penkovlab/6CH_DMX_DECODER/README.md

# 6CH_DMX_DECODER
DMX декодер предназначен для установки внутрь светодиодного светильника. Преобразует цифровой сигнал DMX512 в ШИМ (сигнал с широтно-импульсной модуляцией). К выходу устройства подключаются светодиодные драйверы с ШИМ управлением яркостью. Совместимость с протоколом DMX-512 позволяет управлять световым прибором с любого DMX контроллера.
6CH_DMX_48V(1)
6CH_DMX_48V(2)
# Характеристики
    • Напряжение питания: 9-48 В
    • Потребляемый ток при 9В: 80 мА
    • Потребляемый ток при 48В: 16 мА
    • Входной сигнал: DMX512
    • Число выходных каналов: 6
    • Тип выхода: открытый коллектор
    • Максимальный ток выхода: 250 мА
    • Максимальное напряжение на выходе: 48 В
    • Частота выходного ШИМ сигнала: 120/490/3900 Гц
    • Разрешение выходного ШИМ сигнала: 8 бит
    • Габаритные размеры: 65 * 30 * 18 мм (Д*Ш*В)
# Особенности
    • Гальваническая изоляция линии DMX.
    • Стартовый адрес устанавливается при помощи редактора адресов по линии DMX, не требуя никаких дополнительных подключений. 
    • Полное соответствие стандарту USITT DMX512(1990).
    • Имеет защиту от ошибочного подключения питания обратной полярности.
    • Возможность инвертирования выходного сигнала для работы с различными драйверами. 
    • Выбор графика изменения выходного шим сигнала (линейный/логарифмический).
    • Изменение настроек при помощи джамперов на плате.
# Конфигурация установкой перемычек
    • Перемычки J1 - J2 используются для выбора частоты выходного ШИМ сигнала
    • Перемычка J3 используется для инвертирования выходного ШИМ сигнала. Инвертирование выходного сигнала может понадобиться для работы с некоторыми светодиодными драйверами у которых включение происходит при замыкании входа диммирования на землю.
    • Перемычка J4 используется для выбора графика изменения выходного ШИМ сигнала. Установкой перемычки вы можете переключить декодер из линейного режима в режим логарифмической ШИМ.
