penkovlab/6CH_DMX_DECODER/6CH_DMX_48V - BOM.ods

Ref Name | Qty | Component | Value | Package | Manufacturer | Description
U2 | 1 | ADUM5241ARZ-RL7 |  | SOIC-8 | AD | Двухканальный изолятор с мощным интегральным DC/ DC преобразователем | 413 | 413
DD1 | 1 | ATMEGA48PA-AU |  | TQFP-32 | Microchip | Микроконтроллер AVR | 250 | 250
U4 | 1 | LM5007MM/NOPB |  | VSSOP-8 | Texas Instruments | Constant On-Time (COT) Step-Down DC/DC Converters (Integrated Switch) | 120 | 120
U1 | 1 | MAX485ESA |  | SOIC-8 | Maxim | RS-485 Single Transmitters/Receivers | 61 | 61
CONN1 | 1 | DS1013-06SSiB1 |  |  | Connfly | Вилка на плату прямая 6 контактов | 5 | 5
X1-5 | 1 | DS1021-2*5SF11-B |  |  | Connfly | Вилка штыревая 2.54мм 2x5 прямая тип1 | 5 | 5
FS1, FS2, FS3 | 3 | MF-MSMF020 |  | 1812 | Bourns | Предохранитель самовосстанавливающийся | 10 | 30
C16 | 1 | B32529C1103J000 | 10n_100V_5% |  | EPCOS | Пленочный конденсатор | 6 | 6
C15 | 1 | B32529C1473J000 | 47n_100V_5% |  | EPCOS | Пленочный конденсатор | 6 | 6
D4 | 1 | CDSOT23-SM712 |  | CDSOT23 | Bourns | Transient Voltage Suppressors | 25 | 25
ZQ1 | 1 |  | 16MHz 20pF | HC49S | Caltron | Кварцевый резонатор, усеченный | 20 | 20
L1 | 1 | RLB0914-102KL | 1mH |  | Bourns | Дроссель | 23 | 23
C9 | 1 | GRM21BR71H105KA12L | 1u_50V_X7R | 0805 | Murata |  | 3 | 3
C8 | 1 | GRM216R71H103KA01D | 10n_50V_X7R | 0805 | Murata |  | 3 | 3
C1, C2 | 2 | GRM21B5C1H223JA01L | 22p_50V_C0G(NP0) | 0805 | Murata |  | 3 | 6
C3, C4, C5, C7 | 4 | GRM21BR71H104K | 100n_50V_X7R | 0805 | Murata |  | 3 | 12
C13, C14 | 2 | GRM319R72A104KA01D | 100n_100V_X7R | 1206 | Murata |  | 3 | 6
C11 | 1 | TKR330M2AF11 | 33u_100V_8x11 |  | Jamicon |  | 3 | 3
U3 | 1 | PC817 |  | SMD-4 |  | Оптопара | 7 | 7
R4, R5, R10, R11, R12, R13, R15, R16 | 8 | AC0805JR-071KL | 1k_5% | 0805 | Yageo |  | 0,3 | 2,4
R7,R8 | 2 | AC0805FR-071KL | 1k_1% | 0805 | Yageo |  | 0,3 | 0,6
R1 | 1 | AC0805JR-0710KL | 10k_5% | 0805 | Yageo |  | 0,3 | 0,3
R2, R3 | 2 | RC0805JR-0710RL | 10R_5% | 0805 | Yageo |  | 0,3 | 0,6
R14 | 1 | RC0805JR-0762KL | 62k_5% | 0805 | Yageo |  | 0,3 | 0,3
R6 | 1 | RC0805FR-07130KL | 130k_1% | 0805 | Yageo |  | 0,3 | 0,3
R9 | 1 | RC0805FR-07360KL | 360K_1% | 0805 | Yageo |  | 0,3 | 0,3
D1, D2 | 2 | SS16 |  | SMA | Vishay | Диод Шоттки | 7 | 14
Q1, Q2, Q3, Q4, Q5, Q6 | 6 | MMBTA42LT1G | NPN_300V_0.5A | SOT23 | ON Semiconductor |  | 4 | 24
C6 | 1 | 293D226X9016C2TE3 | 22uF_16V | CASE C | Vishay |  | 8 | 8
D3 | 1 | SMAJ48CA-TR | 48V | SMA | ST Microelectronics | Двунаправленный TVS | 7 | 7
D5, D6, D7, D8, D9, D10 | 6 | SMF100A | 100V | SOD123 | DIOTEC | Однонаправленный TVS | 3 | 18
 |  |  |  |  |  |  | 1000,1 | 1079,8
 |  |  |  |  |  |  | 75
 |  |  |  |  |  |  | 26
 |  |  |  |  |  |  | 1101,1
