penkovlab/6CH_DMX_DECODER/6CH_DMX_48V - SCH.pdf

# DC-DC (9-48 to 5V)

+9..48V

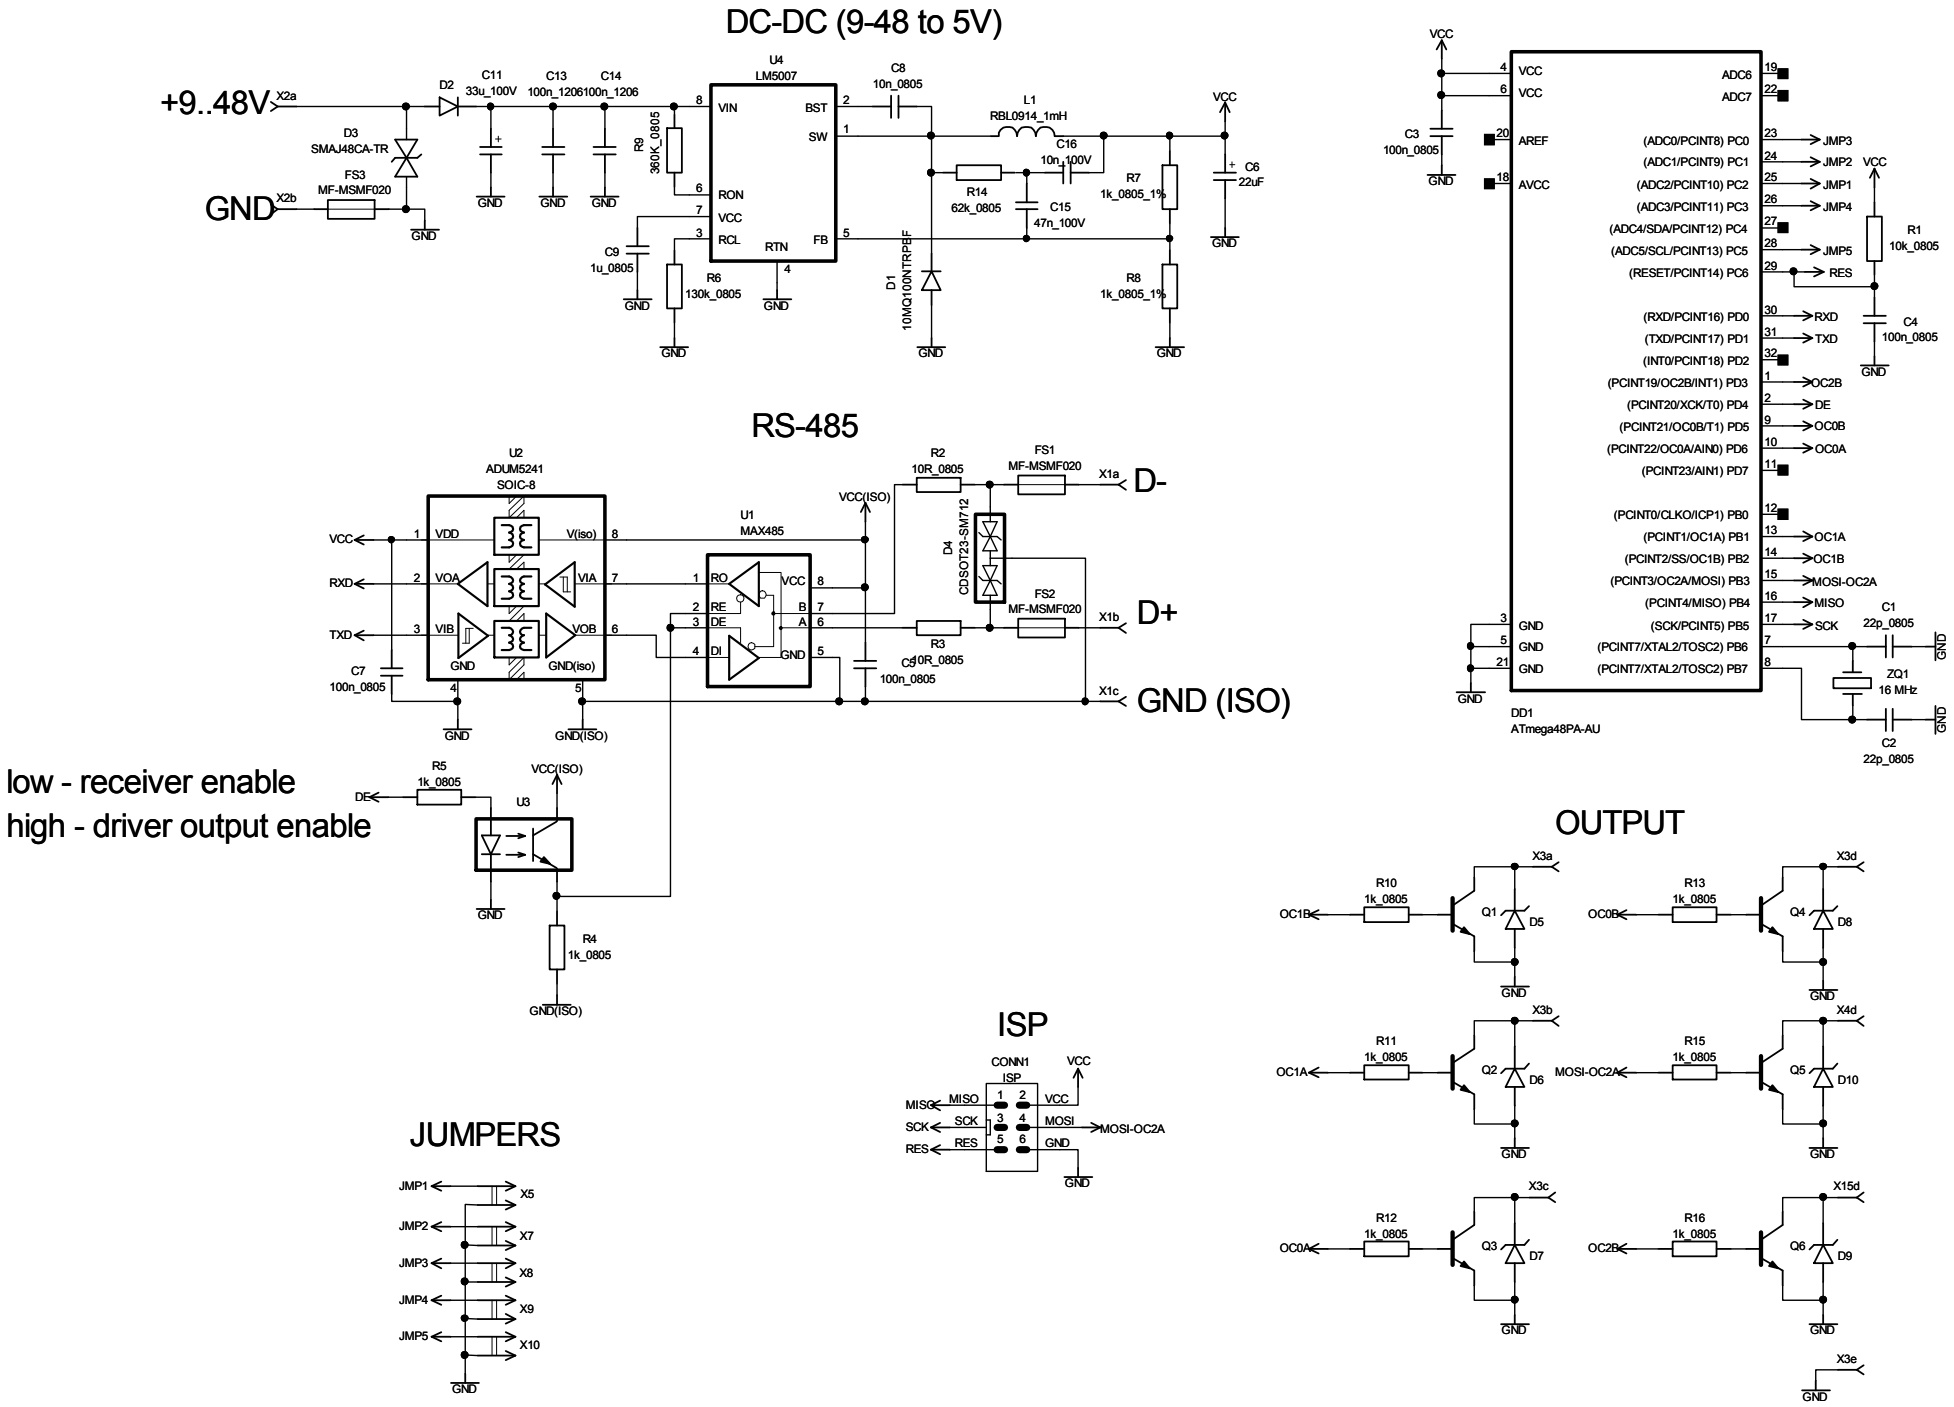
[picture p1: page 1]

low - receiver enable
high - driver output enable
