penkovlab/6CH_DMX_DECODER/(list of files, drawings)

Other design files:
6CH_DMX_48V - PCB.pcb
